Satachito/Digimin/theremin_pico2w/kicad/fabrication/digimin-output-bom.csv

Comment | Designator | Footprint | LCSC Part #
10n 0603B103K500NT | C1,C2 | 0603 | C57112
1k 0603WAF1001T5E | R1,R2 | 0603 | C21190
3.3k 0603WAF3301T5E | R3 | 0603 | C22978
