Satachito/Digimin/theremin_pico2w/kicad/digimin-output.kicad_pcb

## KiCad design theremin_pico2w/kicad/digimin-output.kicad_pcb (2026-11-05)

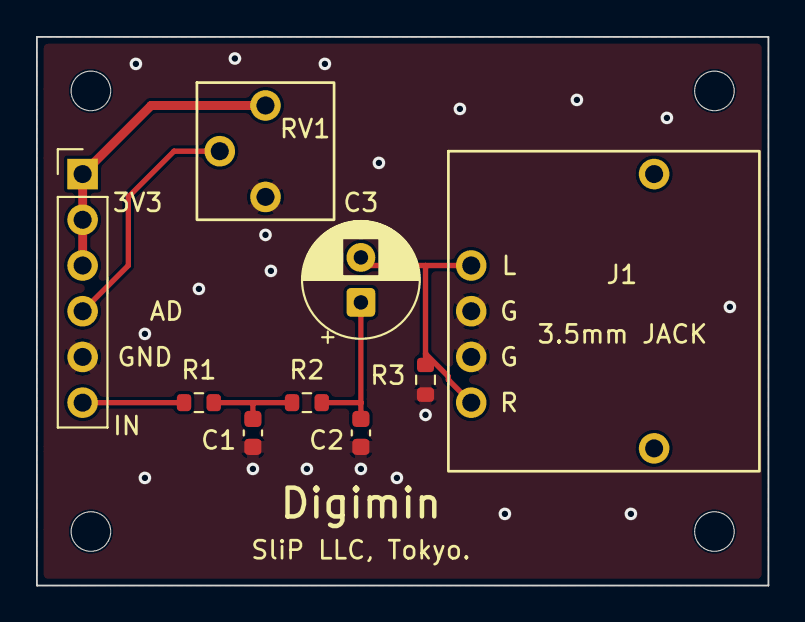
[picture p1: board digimin-output.kicad_pcb from above]

Board: 2 copper layers, 40.6 x 30.5 mm, 13 parts (0 on the bottom side), 7 nets.

Parts:
C1, C2: 10n; C_0603_1608Metric
C3: 10u; CP_Radial_D6.3mm_P2.50mm
H1, H2, H3, H4: M2; MountingHole_2.2mm_M2
J1: 3.5mm Jack (L G G R); Jack_7x7
J2: IN AD GND 3V3; PinHeader_1x06_P2.54mm_Vertical
R1, R2: 1k; R_0603_1608Metric
R3: 3.3k; R_0603_1608Metric
RV1: 10k B; Pot_3x3

Connections:
+3V3: J2.1, J2.2, J2.3, RV1.1
/KNOB: J2.4, RV1.2
/N1: C1.1, R1.2, R2.1
/N2: C2.1, C3.1, R2.2
/OUT: C3.2, J1.1, J1.4, R3.1
/PWM: J2.6, R1.1
GND: C1.2, C2.2, J1.2, J1.3, J2.5, R3.2, RV1.3
