Satachito/Digimin/(commit log)

2026-10-30 Digimin: Pico 2 W theremin firmware, spec and wiring
2026-10-30 SPEC: replace ASCII diagrams with SVG wiring and RC filter drawings
2026-11-01 Move to new pin layout and drop SVG diagrams
    - Pitch sensor on I2C0 (GP20 SDA, GP21 SCL, XSHUT GP17)
    - Volume sensor on I2C1 (GP18 SDA, GP19 SCL, XSHUT GP16)
    - Audio PWM moved to GP22; knob stays on GP28
    - Status line shows the knob position (pot=) and the actual bus
    - SPEC: update pin table, remove outdated SVG wiring drawings
2026-11-01 SPEC: both boards verified on the new pin layout
2026-11-02 README: add pin table
2026-11-02 Knob switches Wi-Fi off/on/open to remove Wi-Fi noise
    Wi-Fi radio activity put a small ~6/s click on the PWM output (3.3V
    ripple). The knob now controls the access point instead of forcing
    100% sine: fully down = Wi-Fi off, up = on (with password if set),
    full up = on without password. Hysteresis 3/6% and 85/90%, 0.7s settle.
    AP address pinned to 192.168.42.1. SPEC/README updated; third board
    Digimin-E738 added to the status table.
    [theremin_pico2w.ino]
2026-11-02 SPEC: drop Digimin-312D from the board list
2026-11-05 SPEC: add ElectroCookie board layout diagram
2026-11-05 SPEC: redraw board diagram from the updated abe.txt
2026-11-05 Add KiCad 2-layer output board with JLCPCB fabrication files
    [digimin-output-B_Cu.gbl, digimin-output-B_Mask.gbs, digimin-output-B_Silkscreen.gbo, digimin-output-Edge_Cuts.gm1, digimin-output-F_Cu.gtl, digimin-output-F_Mask.gts, digimin-output-F_Paste.gtp, digimin-output-F_Silkscreen.gto]
2026-11-05 Stop tracking KiCad lock files
2026-11-05 KiCad: add SliP LLC, Tokyo. to the silkscreen
    [digimin-output-B_Cu.gbl, digimin-output-B_Mask.gbs, digimin-output-B_Silkscreen.gbo, digimin-output-Edge_Cuts.gm1, digimin-output-F_Cu.gtl, digimin-output-F_Mask.gts, digimin-output-F_Paste.gtp, digimin-output-F_Silkscreen.gto]
2026-11-05 KiCad: use the jack footprint from Jack.txt
    Move the L G G R pins to rows 3-6, add two plated reinforcement holes,
    and shift the jack down 2.54 mm to clear the mounting hole.
    [digimin-output-B_Cu.gbl, digimin-output-B_Mask.gbs, digimin-output-B_Silkscreen.gbo, digimin-output-Edge_Cuts.gm1, digimin-output-F_Cu.gtl, digimin-output-F_Mask.gts, digimin-output-F_Paste.gtp, digimin-output-F_Silkscreen.gto]
2026-11-05 Link the Akizuki jack kit and match the diagram to Jack.txt
    [digimin-output-B_Cu.gbl, digimin-output-B_Mask.gbs, digimin-output-B_Silkscreen.gbo, digimin-output-Edge_Cuts.gm1, digimin-output-F_Cu.gtl, digimin-output-F_Mask.gts, digimin-output-F_Paste.gtp, digimin-output-F_Silkscreen.gto]
2026-11-09 Add a PCM5102A DAC build option
    Build with DIGIMIN_DAC=1 to send audio over I2S (PIO, 96 kHz, 16-bit) to a
    PCM5102A module instead of PWM. The DAC build uses its own sensor pins.
    SPEC.md and README describe the wiring and the new Digimin-6C77 board.
2026-11-10 Make the DAC build the default and switch Wi-Fi with GP5/GP9
    The DAC build drops the knob: GP5 to GND turns Wi-Fi off and GP9 to GND
    runs it without a password (an ON-OFF-ON toggle fits). DIGIMIN_DAC now
    defaults to 1, and README and SPEC.md lead with the DAC version, keeping
    the PWM version as the old one.
